Gyuri1999/smart-meter/smart_meter_ESP32-C3.pdf

Smart Meter — ESP32-C3 · ZMPT101B + SCT-013 | smart_meter.ino

# Smart Meter με ESP32-C3 Mini

Μέτρηση τάσης με ZMPT101B (GPIO2) και ρεύματος με SCT-013 (GPIO0). Υπολογίζει Vrms, Irms, πραγματική και φαινόμενη ισχύ, συντελεστή ισχύος και kWh, και τα δημοσιεύει σε MQTT με Home

## Assistant auto-discovery. Οι τιμές βαθμονόμησης σε αυτό το έγγραφο είναι μετρημένες πάνω

στην πραγματική διάταξη, όχι θεωρητικές.

# 1. Συνδεσμολογία

Εξάρτημα | Ακροδέκτης | ESP32-C3 | Σημείωση
ZMPT101B | VCC | 3V3 | Κρίσιμο. Με 5 V το σημείο ηρεμίας πάει στα 2.5 V, η κορυφή χτυπάει στο ταβάνι του ADC (2.85 V) και το ημίτονο κόβεται· επιπλέον καταπονείται το GPIO2.
ZMPT101B | OUT | GPIO2 (ADC1_CH2) | Το ποτενσιόμετρο ρυθμίζει το πλάτος — δες §3
ZMPT101B | GND | GND | Κοινή γείωση
SCT-013 | σήμα (tip) | GPIO0 (ADC1_CH0) | Μέσο διαιρέτη 10k/10k → bias 1.65 V
SCT-013 | sleeve | GND | Το βέλος του clamp προς το φορτίο
R1 / R2 | 10 kΩ | 3V3 → GPIO0 → GND | Διαιρέτης πόλωσης· το 3V3 το μοιράζεται με το ZMPT101B
C | 10 µF | GPIO0 → GND | Χαμηλή σύνθετη αντίσταση για το AC σήμα
230V AC | ESP32-C3 Mini
~~~~~~~ | ~~~~~~~~~~~~~
L o---+---[ ZMPT101B ]--- OUT -------------------> GPIO2 | (ADC1_CH2)
| | VCC <-- 3V3 | !!! ΟΧΙ 5V !!!
N o---+ | GND <-- GND
3V3
[ ] R1 10k
SCT-013 (clamp) | |
+---------+ | +-----+-------> GPIO0 | (ADC1_CH0)
| tip | |----------------------------+ | |
| sleeve |----------------------------+ | === | C 10uF
+---------+ | | | |
[ ] R2 10k
GND---GND

* Το SCT-013 με έξοδο τάσης έχει ΕΝΣΩΜΑΤΩΜΕΝΟ burden -> ΜΗΝ βάλεις αντίσταση. * Το βέλος του clamp δείχνει προς το φορτίο, αλλιώς η ισχύς βγαίνει αρνητική. * Κοινή GND παντού. Το 3V3 τροφοδοτεί ΚΑΙ το ZMPT101B ΚΑΙ τον διαιρέτη.

# 2. Ρυθμίσεις Arduino IDE

### - Board: ESP32C3 Dev Module (πακέτο esp32 by Espressif· δοκιμασμένο σε 3.3.10)

- USB CDC On Boot: Enabled — χωρίς αυτό ο Serial βγαίνει στα pins και ο monitor μένει κενός

### - Serial Monitor: 115200 baud

### - Η ίδια έξοδος βγαίνει και στο UART0 (GPIO21=TX, GPIO20=RX) για μετατροπέα USB-TTL

- Βιβλιοθήκη: μόνο PubSubClient (Nick O’Leary). Οι υπολογισμοί δεν χρησιμοποιούν EmonLib.

# 3. Βαθμονόμηση — μετρημένες τιμές

Οι τέσσερις σταθερές στην αρχή του αρχείου. Οι τιμές που ακολουθούν προέκυψαν από σύγκριση με πολύμετρο και αμπεροτσιμπίδα πάνω στην πραγματική διάταξη.

Σταθερά | Τιμή | Πώς βρέθηκε
VCAL | 341.0 | Volt δικτύου ανά 1 V στο pin. Σύγκριση με πολύμετρο: ένδειξη 231.7 V έναντι 233 V → απόκλιση 0.55%. Αναπροσαρμογή: VCAL_νέο = VCAL_παλιό × (πολύμετρο ÷ ένδειξη).
ICAL | 25.75 | Ampere ανά 1 V στο pin. Θεωρητικά ένα SCT-013-030 θα ήθελε 30.0· το συγκεκριμένο clamp βγήκε ~25.8. Τέσσερις συγκρίσεις σε 4.6 και 8.8 A έδωσαν 25.99 / 25.77 / 25.86 / 25.41 — μέση τιμή 25.76, διασπορά 1%.
PHASE_SHIFT | 12 | Διόρθωση φάσης σε ολόκληρα δείγματα. Ο μετασχηματιστής του ZMPT101B εισάγει 27.9° μετατόπιση: χωρίς διόρθωση το PF βγαίνει 0.88 σε καθαρά ωμικό φορτίο και η ισχύς είναι 12% λάθος. Βρίσκεται αυτόματα από τη σάρωση [sweep].
PHASECAL | 1.0 | Λεπτή ρύθμιση μέσα σε ένα δείγμα (±2.5°). Δεν χρειάστηκε.

### Σειρά εργασιών. Πρώτα το σχήμα, μετά η κλίμακα, τέλος η φάση:

- Ρύθμισε το ποτενσιόμετρο ώστε το CF να είναι 1.35–1.45 και το max να μένει κάτω από 2800 mV. Όσο το

max είναι καρφωμένο στα 2853 το ημίτονο κόβεται, όποιο κι αν είναι το CF.
- Σύγκρινε την τάση με πολύμετρο και διόρθωσε το VCAL.
- Σύγκρινε το ρεύμα με αμπεροτσιμπίδα σε δύο διαφορετικά φορτία και διόρθωσε το ICAL. Δύο σημεία

αποδεικνύουν γραμμικότητα, ένα όχι.
- Με ωμικό φορτίο άναψε τη σάρωση φάσης και πέρασε το προτεινόμενο PHASE_SHIFT.

Το ZMPT101B συνδέεται στα 230 V AC. Κάθε επέμβαση με το κύκλωμα αποσυνδεδεμένο· για τη ρύθμιση του trimmer υπό τάση, μονωμένο κατσαβίδι και κλειστό κουτί.

# 4. Διαγνωστικά στη σειριακή

Με PRINT_DEBUG 1 τυπώνονται τρία εργαλεία που φτιάχτηκαν ακριβώς για να στηθεί αυτή η διάταξη:

Γραμμή | Τι σου λέει
[dbg] | Τα δύο offsets (πρέπει και τα δύο ~1650 mV), ο αριθμός δειγμάτων (~2800 με σήμα, ~70 χωρίς), τα άκρα του καναλιού τάσης και το crest factor. Προειδοποιεί όταν η κορυφή ακουμπάει το ταβάνι του ADC.
[I-only] | Μέτρηση ρεύματος σε σταθερό παράθυρο 300 ms, ανεξάρτητη από την τάση. Τρέχει μόνη της όταν δεν υπάρχει σήμα τάσης, ώστε να ελέγχεις το clamp χωριστά. Δείχνει και το ptp: πραγματικό ημίτονο έχει ptp ≈ 2.83 × rms, ενώ ο θόρυβος 10–20 φορές το rms.
[sweep] | Καταγράφει 2048 δείγματα και δοκιμάζει 49 μετατοπίσεις φάσης. Με ωμικό φορτίο, η μετατόπιση με το μέγιστο PF είναι η σωστή. Τρέχει αυτόματα πάνω από 1 A.

# 5. MQTT

Συμπλήρωσε SSID, κωδικό και IP του broker στην αρχή του αρχείου. Με USE_MQTT 0 ο μετρητής δουλεύει αυτόνομος. Το <id> είναι τα τρία τελευταία byte της MAC και τυπώνεται στην εκκίνηση.

Topic | Περιεχόμενο
smartmeter/<id>/state | JSON με όλες τις μετρήσεις, κάθε 5 s
smartmeter/<id>/availability | online / offline (retained, με Last Will)
homeassistant/sensor/smartmeter_<i d>/…/config | Έξι μηνύματα auto-discovery, retained. Απενεργοποιούνται με HA_DISCOVERY 0
smartmeter/<id>/availability | online
smartmeter/<id>/state | {"v":232.61,"i":9.012,"p":2087.3,"s":2096.3,"pf":1.00,"e":0.1153,"rssi":-69}

Το Home Assistant φτιάχνει μόνο του μία συσκευή «Smart Meter» με έξι οντότητες. Η ενέργεια δηλώνεται total_increasing, οπότε μπαίνει στον Energy Dashboard.

# 6. Παράδειγμα εξόδου

==================================================
Smart Meter - ESP32-C3 | ZMPT101B(GPIO2) SCT-013(GPIO0)
==================================================
VCAL=341.00 | ICAL=25.75 | PHASECAL=1.00 | PHASE_SHIFT=12
Device ID : 8459a0
MQTT topic: smartmeter/8459a0/state
Εξοδος | : USB CDC + UART0 (GPIO21=TX, GPIO20=RX) @ 115200 baud
[wifi] συνδεθηκε: IP=192.168.1.43 | gateway=192.168.1.1 | RSSI=-69 dBm
[mqtt] συνδέθηκε στον 192.168.1.17
[mqtt] στάλθηκε το Home Assistant discovery
V= 232.61 V | I= 9.012 A | P= | 2087.3 W | S= | 2096.3 VA | PF= 1.00 | E= | 0.115 kWh

# 7. Κώδικας — smart_meter.ino

Τα στοιχεία WiFi και MQTT εμφανίζονται ως placeholder.

1 /* ============================================================================
2 | SMART METER | -- | ESP32-C3 Mini
3 | ----------------------------------------------------------------------------
4 | Αισθητήρας τάσης | : ZMPT101B (module με τελεστικό + ποτενσιόμετρο) -> GPIO2
5 | Αισθητήρας ρεύματος: SCT-013 30A/1V (έξοδος τάσης, ΜΕ εσωτερικό burden)
6 | -> GPIO0, με διαιρέτη τάσης 10k/10k (bias 1.65V)
7 | και πυκνωτή 10uF από το μέσο του διαιρέτη προς GND.
8
9 | Μετράει: Vrms, Irms, Πραγματική Ισχύ (W), Φαινόμενη (VA), cos(φ), kWh
10 | και τα δημοσιεύει σε MQTT (με προαιρετικό Home Assistant auto-discovery).
11
12 Απαιτεί τη βιβλιοθήκη: PubSubClient (Nick O'Leary) - Library Manager. 13
14 | !!! ΠΡΟΣΟΧΗ: το ZMPT101B συνδέεται στα 230V AC. Δούλεψε με το κύκλωμα
15 | ΑΠΟΣΥΝΔΕΔΕΜΕΝΟ από το δίκτυο. Μόνωση, κουτί, ασφάλεια.
16 | ============================================================================ */
17
18 // ------------------------------------------------------------ WiFi / MQTT
19 #define USE_MQTT | 1 | // 0 = μόνο σειριακή, χωρίς δίκτυο
20 #define HA_DISCOVERY | 1 | // 1 = αυτόματη αναγνώριση από Home Assistant
21
22 #if USE_MQTT
23 | #include <WiFi.h>
24 | #include <PubSubClient.h>
25
26 | static const char *WIFI_SSID = "TO_DIKTYO_MOU";
27 | static const char *WIFI_PASS = "TO_PASSWORD_MOU";
28
29 | static const char *MQTT_HOST = "192.168.1.17"; | // IP του broker
30 | static const uint16_t MQTT_PORT = 1883;
31 | static const char *MQTT_USER = "O_XRHSTHS_MOU"; | // "" αν δεν χρειάζεται
32 | static const char *MQTT_PASS = "TO_PASSWORD_TOU_BROKER";
33
34 | static const char *MQTT_BASE = "smartmeter"; | // ρίζα των topics
35 | static const uint32_t PUBLISH_EVERY_MS = 5000; | // κάθε πότε δημοσιεύουμε
36 #endif
37
38 // ---------------------------------------------------------------- ΑΚΡΟΔΕΚΤΕΣ
39 static const int PIN_VOLT = 2; | // ZMPT101B | OUT | (ADC1_CH2)
40 static const int PIN_CURR = 0; | // SCT-013 | sig | (ADC1_CH0)
41
42 // ------------------------------------------------------------- ΒΑΘΜΟΝΟΜΗΣΗ
43 // VCAL: πόσα Volt AC του δικτύου αντιστοιχούν σε 1 V στο pin.
44 // | Ξεκίνα με 260.0 και διόρθωσε: VCAL_new = VCAL_old * (Vπολύμετρου / Vσειριακής)
45 float VCAL = 341.0f;
46
47 // ICAL: πόσα Ampere αντιστοιχούν σε 1 V στο pin.
48 // | SCT-013-030 (30A/1V) απευθείας στο pin | -> 30.0
49 // | SCT-013-010 (10A/1V) | -> 10.0
50 // | Αν έβαλες επιπλέον διαιρέτη ΠΑΝΩ στο σήμα (π.χ. /2) -> διπλασίασε το.
51 float ICAL = 25.75f;
52
53 // PHASECAL: διόρθωση διαφοράς φάσης V/I (1.0 = καμία διόρθωση).
54 // | Ρύθμισέ το με καθαρά ωμικό φορτίο ώστε cos(φ) ~ 1.00 (τυπικά 0.8 - 2.2)
55 float PHASECAL = 1.0f;
56
57 // PHASE_SHIFT: χονδρική διόρθωση φάσης σε ΟΛΟΚΛΗΡΑ δείγματα (το PHASECAL
58 // καλύπτει μόνο ±1 δείγμα = ±2.5 μοίρες, πολύ λίγο για τη μετατόπιση που 59 // εισάγει ο μετασχηματιστής του ZMPT101B). Θετικό = καθυστερεί την τάση.

60 // Βρες την τιμή με τη σάρωση [sweep] που τρέχει αυτόματα υπό φορτίο.
61 int PHASE_SHIFT = 12;
62
63 // -------------------------------------------------------------- ΔΕΙΓΜΑΤΟΛΗΨΙΑ
64 static const int | HALF_CYCLES | = 40; | // 39 ημιπερίοδοι = 19.5 περίοδοι @50Hz (~390 ms)
65 static const uint32_t TIMEOUT_MS | = 1500; | // ασφάλεια αν δεν υπάρχει σήμα
66 static const double | FILT_TAU | = 1024.0; // σταθερά φίλτρου DC offset
67 static const float | NOISE_V | = 5.0f; | // κάτω από αυτό -> 0 (Volt)
68 static const float | NOISE_I | = 0.50f; | // κάτω από αυτό -> 0 (μετρημένος θόρυβος ~0.3 A)
69
70 // Αν το clamp είναι ανάποδα και δεν βολεύει να το γυρίσεις (π.χ. μόνιμη
71 // εγκατάσταση), βάλε 1 και αντιστρέφεται το πρόσημο της ισχύος από λογισμικό.
72 #define INVERT_CURRENT 0
73
74 #define PRINT_DEBUG 1 | // 1 = τύπωσε offsets/δείγματα
75
76 // --------------------------------------------------------------- ΜΕΤΑΒΛΗΤΕΣ 77 static double offsetV = 1650.0; // DC offset σε mV (ξεκινά στο μισό των 3.3V) 78 static double offsetI = 1650.0;
79
80 static double energy_Wh = 0.0; // συσσωρευμένη ενέργεια
81 static uint32_t lastEnergy_ms = 0;
82
83 struct Reading {
84 | float | vrms; | // V
85 | float | irms; | // A
86 | float | realPower; | // W
87 | float | apparentPower; // VA
88 | float | powerFactor; | // 0..1
89 | int | samples;
90 | int | vmin, vmax; | // ακραίες τιμές του καναλιού τάσης, σε mV (έλεγχος clipping)
91 | bool | ok;
92 };
93
94 // ------------------------------------------------------------------ ΕΞΟΔΟΣ 95 // Τα μηνύματα βγαίνουν ταυτόχρονα σε δύο σημεία:
96 // | * USB CDC | -> ο Serial Monitor μέσω του καλωδίου προγραμματισμού
97 // | * hardware UART0 -> GPIO21 = TX, GPIO20 = RX, για μετατροπέα USB-TTL
98 // Έτσι βλέπεις την έξοδο ακόμη κι αν το USB CDC δεν είναι διαθέσιμο (π.χ. 99 // λάθος ρύθμιση "USB CDC On Boot", ή όταν το ESP32 τροφοδοτείται χωριστά). 100 #define LOG_TO_UART 1
101 static const uint32_t LOG_BAUD = 115200;
102
103 // Αν το USB CDC είναι απενεργοποιημένο, ο Serial ΕΙΝΑΙ ήδη ο UART0 -> μη 104 // γράψεις δύο φορές στο ίδιο πράγμα.
105 #if LOG_TO_UART && ARDUINO_USB_CDC_ON_BOOT
106 #define LOG_DUAL 1
107 #else
108 #define LOG_DUAL 0
109 #endif
110
111 static void logBegin() {
112 Serial.begin(LOG_BAUD);
113 #if LOG_DUAL
114 | Serial0.begin(LOG_BAUD); | // GPIO21 TX / GPIO20 RX
115 #endif
116 | // Με USB CDC η θύρα ξαναδηλώνεται στο USB μετά το reset. Χωρίς αυτή την
117 | // αναμονή, τα πρώτα μηνύματα χάνονται πριν προλάβει να συνδεθεί ο monitor.
118 | while (!Serial && millis() < 3000) delay(10);
119 | delay(500);
120 }
121
122 static void logf(const char *fmt, ...) {
123 | char buf[224];
124 | va_list ap;
125 | va_start(ap, fmt);
126 | vsnprintf(buf, sizeof(buf), fmt, ap);
127 | va_end(ap);
128
129 Serial.print(buf);
130 #if LOG_DUAL
131 Serial0.print(buf);
132 #endif
133 }
134
135 // ------------------------------------------------------------------ ΜΕΤΡΗΣΗ 136 static Reading measure() {
137 Reading r = {0, 0, 0, 0, 0, 0, 5000, 0, false};

139 const uint32_t tStart = millis();
140
141 | // 1) Warm-up: αφήνουμε το φίλτρο DC offset να "κλειδώσει"
142 | while (millis() - tStart < 60) {
143 | offsetV += (analogReadMilliVolts(PIN_VOLT) - offsetV) / FILT_TAU;
144 | offsetI += (analogReadMilliVolts(PIN_CURR) - offsetI) / FILT_TAU;
145 | }
146
147 | // 2) Κύρια δειγματοληψία, συγχρονισμένη σε μηδενισμούς της τάσης
148 | const int PBUF = 32; | // > |PHASE_SHIFT| + 1
149 | static double pbufV[32], pbufI[32];
150 | int tick = 0;
151
152 | double sumV = 0, sumI = 0, sumP = 0;
153 | double lastFilteredV = 0;
154 | int | crossCount = 0;
155 | int | n = 0;
156 | bool | started = false;
157
158 | // Αρχικοποίηση προσήμου από το τρέχον δείγμα, ώστε ο πρώτος μηδενισμός
159 | // που θα ανιχνευτεί να είναι πραγματικός -> αθροίζουμε ακέραιο αριθμό
160 | // ημιπεριόδων και το RMS βγαίνει ακριβές.
161 | bool | lastSign = (analogReadMilliVolts(PIN_VOLT) - offsetV) > 0;
162
163 | while (crossCount < HALF_CYCLES) {
164 | if (millis() - tStart > TIMEOUT_MS) return r; | // ok = false
165
166 | int | rawV = analogReadMilliVolts(PIN_VOLT);
167 | double sV = rawV;
168 | double sI = analogReadMilliVolts(PIN_CURR);
169
170 | if (rawV < r.vmin) r.vmin = rawV;
171 | if (rawV > r.vmax) r.vmax = rawV;
172
173 | offsetV += (sV - offsetV) / FILT_TAU;
174 | offsetI += (sI - offsetI) / FILT_TAU;
175
176 | double fV = sV - offsetV; | // AC συνιστώσα τάσης | (mV στο pin)
177 | double fI = sI - offsetI; | // AC συνιστώσα ρεύματος (mV στο pin)
178
179 | bool sign = (fV > 0);
180 | if (sign != lastSign) {
181 | crossCount++;
182 | if (!started) { | // ξεκίνα να αθροίζεις από τον 1ο μηδενισμό
183 | started = true;
184 | sumV = sumI = sumP = 0;
185 | n = 0;
186 | }
187 | }
188 | lastSign = sign;
189
190 | // Γράψε τα δείγματα στον κυκλικό buffer και διάβασε τα μετατοπισμένα.
191 | int pi = tick % PBUF;
192 | pbufV[pi] = fV;
193 | pbufI[pi] = fI;
194 | int kv = (PHASE_SHIFT > 0) ? | PHASE_SHIFT : 0; | // καθυστέρηση τάσης
195 | int ki = (PHASE_SHIFT < 0) ? -PHASE_SHIFT : 0; | // καθυστέρηση ρεύματος
196 | double v0 = pbufV[(pi - kv | + PBUF) % PBUF];
197 | double v1 = pbufV[(pi - kv - 1 + PBUF) % PBUF];
198 | double phaseShiftedV = v1 + PHASECAL * (v0 - v1); | // λεπτή ρύθμιση
199 | double iShifted | = pbufI[(pi - ki + PBUF) % PBUF];
200
201 | if (started && tick >= PBUF) {
202 | sumV += fV * fV;
203 | sumI += fI * fI;
204 | sumP += phaseShiftedV * iShifted;
205 | n++;
206 | }
207 | tick++;
208 | lastFilteredV = fV;
209 | }
210
211 if (n < 10) return r;
212
213 | // 3) Υπολογισμοί (mV -> V, μετά επί τους συντελεστές βαθμονόμησης)
214 | double vrms_pin = sqrt(sumV / n) / 1000.0; | // V στο pin
215 | double irms_pin = sqrt(sumI / n) / 1000.0; | // V στο pin
216
217 | r.vrms | = VCAL * vrms_pin;

218 | r.irms | = ICAL * irms_pin;
219 | r.realPower = VCAL * ICAL * (sumP / n) / 1.0e6;
220
221 | if (r.vrms < NOISE_V) { r.vrms = 0; r.realPower = 0; }
222 | if (r.irms < NOISE_I) { r.irms = 0; r.realPower = 0; }
223
224 #if INVERT_CURRENT
225 r.realPower = -r.realPower;
226 #endif
227
228 | r.apparentPower = r.vrms * r.irms;
229 | r.powerFactor | = (r.apparentPower > 0.5f) ? (r.realPower / r.apparentPower) : 0.0f;
230 | if (r.powerFactor > | 1.0f) r.powerFactor = | 1.0f;
231 | if (r.powerFactor < -1.0f) r.powerFactor = -1.0f;
232
233 | r.samples = n;
234 | r.ok = true;
235 | return r;
236 }
237
238 // ------------------------------------------------------------- ΔΙΚΤΥΟ MQTT 239 #if USE_MQTT
240
241 static WiFiClient wifiClient;
242 static PubSubClient mqtt(wifiClient);
243
244 static char devId[8] | = ""; | // τα 3 τελευταία byte της MAC, π.χ. "a1b2c3"
245 static char t_state[64] = ""; | // smartmeter/a1b2c3/state
246 static char t_avail[64] = ""; | // smartmeter/a1b2c3/availability
247 static uint32_t lastNetTry | = 0;
248 static uint32_t lastPublish = 0;
249
250 // Στοιχεία που δημοσιεύονται. Το "key" είναι και το πεδίο του JSON. 251 struct SensorDef {
252 const char *key, *name, *unit, *devClass, *stateClass;
253 };
254 static const SensorDef SENSORS[] = {
255 | {"v", | "Τάση", | "V", | "voltage", | "measurement"},
256 | {"i", | "Ρεύμα", | "A", | "current", | "measurement"},
257 | {"p", | "Ισχύς", | "W", | "power", | "measurement"},
258 | {"s", | "Φαινόμενη ισχύς", | "VA", | "apparent_power", "measurement"},
259 | {"pf", "Συντελεστής ισχύος", "", | "power_factor", | "measurement"},
260 | {"e", | "Ενέργεια", | "kWh", "energy", | "total_increasing"},
261 };
262
263 static void netSetup() {
264 | WiFi.mode(WIFI_STA);
265 | WiFi.setSleep(false); | // σταθερότερη σύνδεση, λιγότερα stalls
266 | WiFi.begin(WIFI_SSID, WIFI_PASS);
267
268 | uint8_t mac[6];
269 | WiFi.macAddress(mac);
270 | snprintf(devId, | sizeof(devId), | "%02x%02x%02x", mac[3], mac[4], mac[5]);
271 | snprintf(t_state, sizeof(t_state), "%s/%s/state", | MQTT_BASE, devId);
272 | snprintf(t_avail, sizeof(t_avail), "%s/%s/availability", MQTT_BASE, devId);
273
274 | mqtt.setServer(MQTT_HOST, MQTT_PORT);
275 | mqtt.setBufferSize(1024); | // τα payloads του discovery δεν χωράνε στα 256
276
277 | logf(" Device ID : %s\n", devId);
278 | logf(" MQTT topic: %s\n", t_state);
279 }
280
281 #if HA_DISCOVERY
282 // Στέλνει ένα retained "config" topic ανά μέγεθος, ώστε το Home Assistant να 283 // φτιάξει μόνο του τις οντότητες κάτω από μία συσκευή.
284 static void publishDiscovery() {
285 char topic[96], payload[640], unitField[48];
286
287 | for (const SensorDef &s : SENSORS) {
288 | snprintf(topic, sizeof(topic),
289 | "homeassistant/sensor/%s_%s/%s/config", MQTT_BASE, devId, s.key);
290
291 | unitField[0] = '\0';
292 | if (s.unit[0]) snprintf(unitField, sizeof(unitField), "\"unit_of_meas\":\"%s\",", s.unit);
293
294 | snprintf(payload, sizeof(payload),
295 | "{\"name\":\"%s\",\"uniq_id\":\"%s_%s_%s\",\"stat_t\":\"%s\",\"avty_t\":\"%s\","
296 | "%s\"dev_cla\":\"%s\",\"stat_cla\":\"%s\",\"val_tpl\":\"{{ value_json.%s }}\","

"\"dev\":{\"ids\":[\"%s_%s\"],\"name\":\"Smart Meter\",\"mf\":\"DIY\"," "\"mdl\":\"ESP32-C3 + ZMPT101B + SCT-013\"}}",
s.name, MQTT_BASE, devId, s.key, t_state, t_avail,
unitField, s.devClass, s.stateClass, s.key,
MQTT_BASE, devId);
303 | mqtt.publish(topic, payload, true); | // retained
}
logf(" [mqtt] στάλθηκε το Home Assistant discovery\n"); 306 }
307 #endif

309 // Μη μπλοκάρουσα διαχείριση σύνδεσης: καλείται συνέχεια από τη loop(). 310 static void netLoop() {
if (WiFi.status() != WL_CONNECTED) {
if (millis() - lastNetTry > 10000) {
lastNetTry = millis();
logf(" [wifi] επανασύνδεση...\n"); WiFi.disconnect();
WiFi.begin(WIFI_SSID, WIFI_PASS); }
return;
}

// Μόλις συνδεθεί το WiFi, τύπωσε μία φορά τη διεύθυνση που πήρε. static bool ipShown = false;
if (!ipShown) {
ipShown = true;
325 | logf(" [wifi] συνδεθηκε: IP=%s | gateway=%s | RSSI=%d dBm\n",
WiFi.localIP().toString().c_str(), WiFi.gatewayIP().toString().c_str(),
| WiFi.RSSI());
}
| if (!mqtt.connected()) {
if (millis() - lastNetTry > 5000) {
| lastNetTry = millis();
| char clientId[32];
snprintf(clientId, sizeof(clientId), "%s_%s", MQTT_BASE, devId);

// Last Will: αν χαθεί η συσκευή, ο broker στέλνει μόνος του "offline". bool ok = mqtt.connect(clientId,
MQTT_USER[0] ? MQTT_USER : nullptr, MQTT_PASS[0] ? MQTT_PASS : nullptr, t_avail, 0, true, "offline");
| if (ok) {
logf(" [mqtt] συνδέθηκε στον %s\n", MQTT_HOST); mqtt.publish(t_avail, "online", true);
345 #if HA_DISCOVERY
| publishDiscovery();
347 #endif
| } else {
logf(" [mqtt] αποτυχία (rc=%d)\n", mqtt.state());
| }
| }
| return;
}
| mqtt.loop();
356 }

358 static void publishState(const Reading &r) {
| if (!mqtt.connected()) return;
| char payload[192];
| snprintf(payload, sizeof(payload),
"{\"v\":%.2f,\"i\":%.3f,\"p\":%.1f,\"s\":%.1f,\"pf\":%.2f,\"e\":%.4f,\"rssi\":%d}", r.vrms, r.irms, r.realPower, r.apparentPower, r.powerFactor,
energy_Wh / 1000.0, WiFi.RSSI());
| mqtt.publish(t_state, payload);
368 }

370 #endif // USE_MQTT

372 // Μετράει ΜΟΝΟ ρεύμα, σε σταθερό παράθυρο χρόνου - δεν εξαρτάται από τους 373 // μηδενισμούς της τάσης. Χρήσιμο για να ελέγξεις το clamp μόνο του, πριν 374 // συνδέσεις το ZMPT101B στο δίκτυο. Τυπώνει και το πλάτος σε mV, ώστε να 375 // ξεχωρίζεις πραγματικό σήμα από θόρυβο.

376 static void currentOnlyReport(uint32_t windowMs) {
377 | const uint32_t t0 = millis();
378 | double sumI = 0;
379 | int n = 0, mn = 5000, mx = 0;
380
381 | while (millis() - t0 < windowMs) {
382 | int raw = analogReadMilliVolts(PIN_CURR);
383 | if (raw < mn) mn = raw;
384 | if (raw > mx) mx = raw;
385 | offsetI += (raw - offsetI) / FILT_TAU;
386 | double fI = raw - offsetI;
387 | sumI += fI * fI;
388 | n++;
389 | }
390
391 | float irms = (n > 9) ? (float)(ICAL * sqrt(sumI / n) / 1000.0) : 0.0f;
392 | logf("[I-only] Irms=%.3f A | ptp=%dmV (%d..%d) | %d δείγματα σε %ums -> %.1f kSPS\n",
393 | irms, mx - mn, mn, mx, n, windowMs, n / (float)windowMs);
394 }
395
396 // ------------------------------------------------------------- ΣΑΡΩΣΗ ΦΑΣΗΣ 397 // Καταγράφει ~290 ms ωμής κυματομορφής και υπολογίζει το PF για κάθε πιθανή 398 // μετατόπιση. Με ΩΜΙΚΟ φορτίο, η μετατόπιση που δίνει το μέγιστο PF είναι η 399 // σωστή τιμή για το PHASE_SHIFT.
400 #define SWEEP_N | 2048
401 #define SWEEP_MAX_K | 24
402
403 static void phaseSweep() {
404 static float bufV[SWEEP_N], bufI[SWEEP_N]; 405
406 | uint32_t t0 = micros();
407 | for (int n = 0; n < SWEEP_N; n++) {
408 | double sV = analogReadMilliVolts(PIN_VOLT);
409 | double sI = analogReadMilliVolts(PIN_CURR);
410 | offsetV += (sV - offsetV) / FILT_TAU;
411 | offsetI += (sI - offsetI) / FILT_TAU;
412 | bufV[n] = sV - offsetV;
413 | bufI[n] = sI - offsetI;
414 | }
415 | float fs = SWEEP_N / ((micros() - t0) / 1.0e6f); | // πραγματικός ρυθμός
416
417 | const int a = SWEEP_MAX_K, b = SWEEP_N - SWEEP_MAX_K;
418 | double sv = 0, si = 0;
419 | for (int n = a; n < b; n++) { sv += (double)bufV[n]*bufV[n]; si += (double)bufI[n]*bufI[n]; }
420 | double vr = sqrt(sv / (b - a)), ir = sqrt(si / (b - a));
421
422 if (vr < 50.0 || ir < 20.0) { logf("[sweep] πολύ μικρό σήμα - βάλε φορτίο\n"); return; } 423
424 | // ΠΡΟΣΟΧΗ: η σάρωση δουλεύει πάνω σε ωμά δείγματα, ΧΩΡΙΣ να εφαρμόζει το
425 | // PHASE_SHIFT. Άρα το bestK είναι η απόλυτη τιμή που πρέπει να μπει εκεί,
426 | // όχι κάτι που προστίθεται στην τρέχουσα.
427 | int bestK = 0; double bestPF = 0, pf0 = 0, pfCur = 0;
428 | for (int k = -SWEEP_MAX_K; k <= SWEEP_MAX_K; k++) {
429 | double sp = 0;
430 | for (int n = a; n < b; n++) sp += (double)bufV[n - k] * bufI[n];
431 | double pf = sp / ((b - a) * vr * ir);
432 | if (k == 0) | pf0 | = pf;
433 | if (k == PHASE_SHIFT) pfCur = pf;
434 | if (fabs(pf) > fabs(bestPF)) { bestPF = pf; bestK = k; }
435 | }
436
437 | logf("[sweep] fs=%.0fHz | αδιορθωτο(0)=%.3f | τρεχον(%d)=%.3f | ΒΕΛΤΙΣΤΟ PHASE_SHIFT=%d -> PF=%.3f (%.1f μοιρες)\n",
438 | fs, pf0, PHASE_SHIFT, pfCur, bestK, bestPF,
439 | bestK * 360.0f * 50.0f / fs);
440 | if (bestPF < 0) logf("[sweep] ΠΡΟΣΟΧΗ: αρνητικο PF -> το clamp ειναι αναποδα\n");
441 }
442
443 // -------------------------------------------------------------------- SETUP
444 void setup() {
445 logBegin();
446
447 | analogReadResolution(12); | // 0..4095
448 | analogSetPinAttenuation(PIN_VOLT, ADC_11db); | // πλήρες εύρος ~0..3.1V
449 | analogSetPinAttenuation(PIN_CURR, ADC_11db);
450
451 | logf("\n");
452 | logf("==================================================\n");
453 | logf(" Smart Meter - ESP32-C3 | ZMPT101B(GPIO2) SCT-013(GPIO0)\n");
454 | logf("==================================================\n");

455 | logf(" VCAL=%.2f | ICAL=%.2f | PHASECAL=%.2f\n", VCAL, ICAL, PHASECAL);
456 #if LOG_DUAL
457 | logf(" Εξοδος | : USB CDC + UART0 (GPIO21=TX, GPIO20=RX) @ %u baud\n", LOG_BAUD);
458 #else
459 | logf(" Εξοδος | : UART0 (GPIO21=TX, GPIO20=RX) @ %u baud\n", LOG_BAUD);
460 #endif
461 logf("\n");
462
463 #if USE_MQTT
464 netSetup();
465 #endif
466
467 | // Μια "τυφλή" μέτρηση για να σταθεροποιηθούν τα φίλτρα
468 | measure();
469 | lastEnergy_ms = millis();
470 }
471
472 // --------------------------------------------------------------------- LOOP 473 void loop() {
474 #if USE_MQTT
475 netLoop();
476 #endif
477
478 Reading r = measure();
479
480 | uint32_t now = millis();
481 | float dt_h = (now - lastEnergy_ms) / 3600000.0f; | // ms -> ώρες
482 | lastEnergy_ms = now;
483
484 | if (!r.ok) {
485 | logf("[!] Δεν ανιχνεύτηκε σήμα τάσης (timeout). Ελέγξτε ZMPT101B / GPIO2.\n");
486 | delay(1000);
487 | return;
488 | }
489
490 energy_Wh += r.realPower * dt_h;
491
492 | // Χωρίς σήμα τάσης η μέτρηση ρεύματος δεν είναι αξιόπιστη (το παράθυρο
493 | // ορίζεται από τους μηδενισμούς της τάσης) -> κάνε ξεχωριστή μέτρηση.
494 | if (r.vrms <= 0.0f) currentOnlyReport(300);
495
496 #if PRINT_DEBUG
497 | // Με φορτίο πάνω από 1 A, τρέξε σάρωση φάσης κάθε 10 δευτερόλεπτα.
498 | static uint32_t lastSweep = 0;
499 | if (r.irms > 1.0f && millis() - lastSweep > 10000) {
500 | lastSweep = millis();
501 | phaseSweep();
502 | }
503 #endif
504
505 #if PRINT_DEBUG
506 | // Crest factor = κορυφή / ενεργός τιμή. Καθαρό ημίτονο -> 1.41.
507 | // Πολύ μικρότερο σημαίνει ότι το σήμα "πλακώνει" (saturation του τελεστικού).
508 | float vrmsPin_mV = (VCAL > 0) ? (r.vrms / VCAL * 1000.0f) : 0.0f;
509 | float crest = (vrmsPin_mV > 1.0f) ? ((r.vmax - r.vmin) / 2.0f) / vrmsPin_mV : 0.0f;
510
511 | logf("[dbg] offsetV=%.0fmV offsetI=%.0fmV samples=%d | V: %d..%d mV ptp=%d CF=%.2f %s\n",
512 | offsetV, offsetI, r.samples, r.vmin, r.vmax, r.vmax - r.vmin, crest,
513 | // Το ταβάνι του ADC είναι ~2850 mV: αν το ακουμπάμε, κόβεται η κορυφή
514 | // ΑΝΕΞΑΡΤΗΤΑ από το τι δείχνει το crest factor.
515 | (r.vmax > 2800 || r.vmin < 150) ? "<<< ΚΟΡΥΦΗ ΣΤΟ ΤΑΒΑΝΙ - χαμηλωσε κι αλλο"
516 | : (crest > 1.33f && crest < 1.50f) ? "OK"
517 | : (crest > 0.0f ? "<<< σχημα ακομα στραβο" : ""));
518 #endif
519
520 | logf("V=%7.2f V | I=%6.3f A | P=%8.1f W | S=%8.1f VA | PF=%5.2f | E=%9.3f kWh\n",
521 | r.vrms, r.irms, r.realPower, r.apparentPower,
522 | r.powerFactor, energy_Wh / 1000.0);
523
524 #if USE_MQTT
525 | if (millis() - lastPublish >= PUBLISH_EVERY_MS) {
526 | lastPublish = millis();
527 | publishState(r);
528 | }
529 #endif
530
531 delay(200);
532 }
