Gyuri1999/smart-meter/hardware/enclosure/preview_back.png

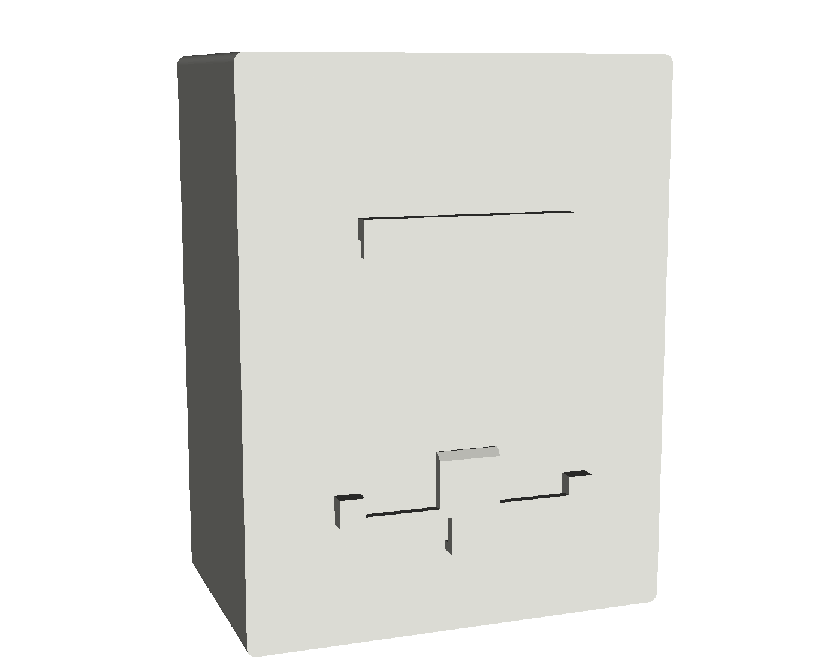
hardware/enclosure/preview_back.png
