Gyuri1999/smart-meter/hardware/enclosure/preview_open.png

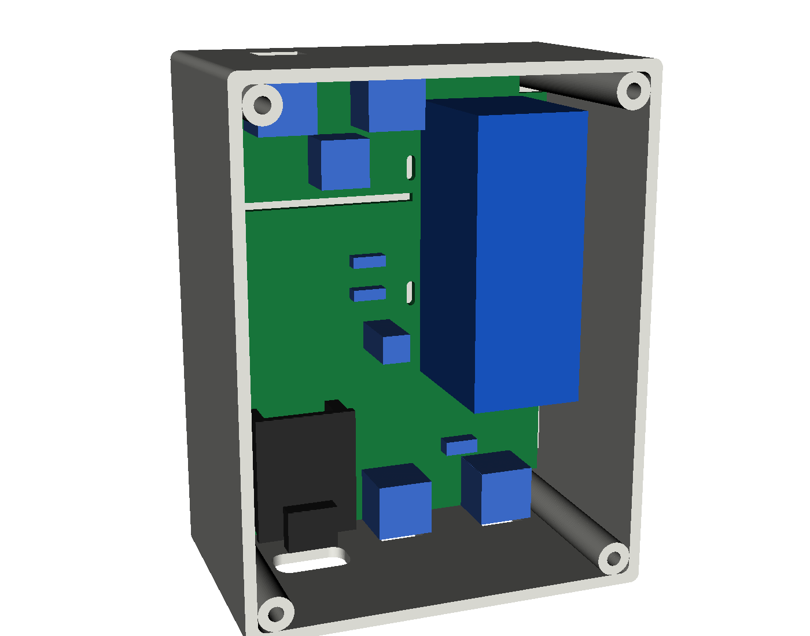
hardware/enclosure/preview_open.png
