Gyuri1999/smart-meter/hardware/pcb/placement.png

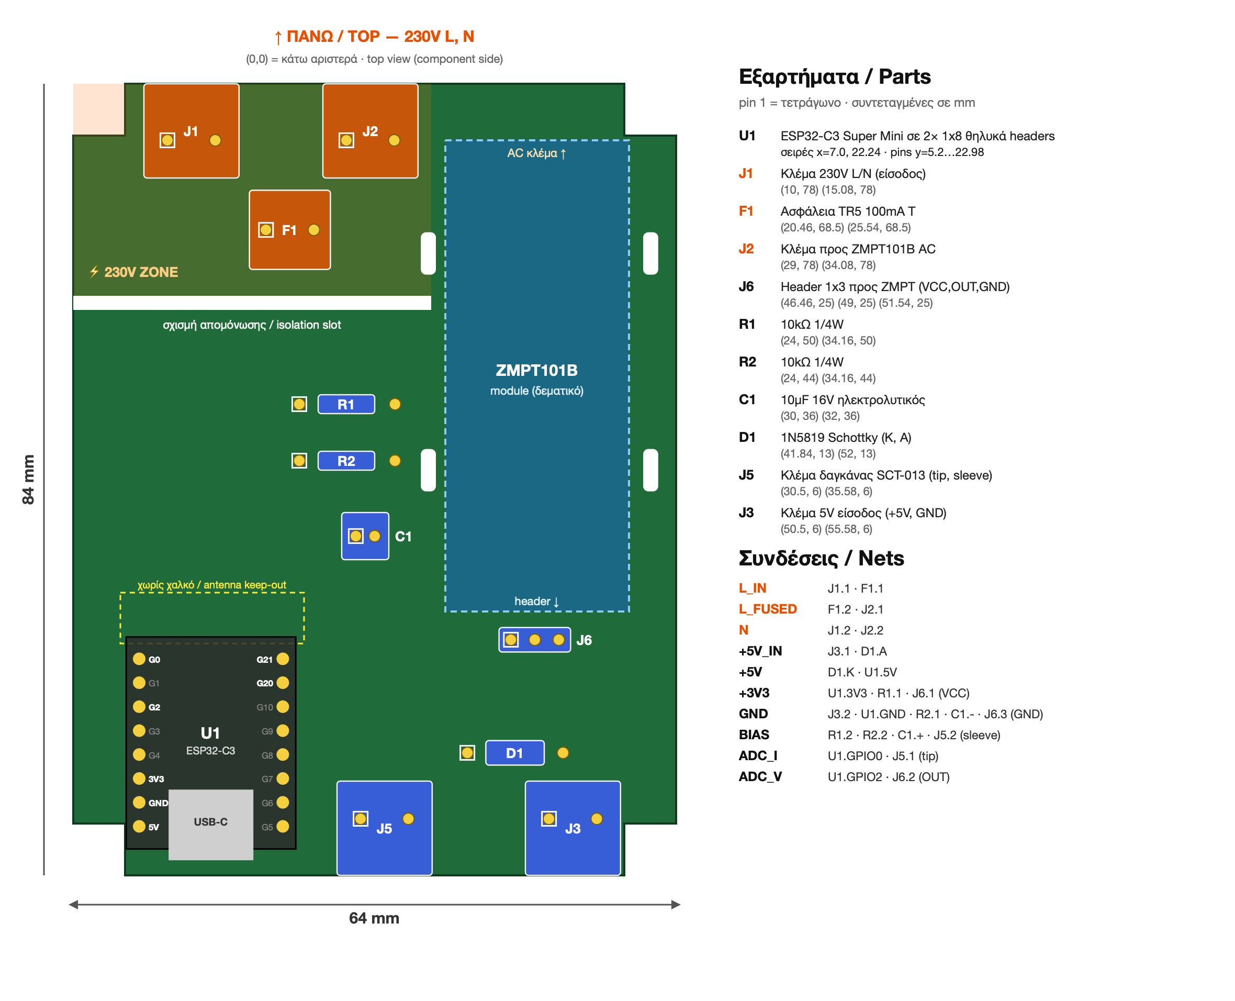
hardware/pcb/placement.png
