Gyuri1999/smart-meter/hardware/enclosure/smart_meter_assembly.step

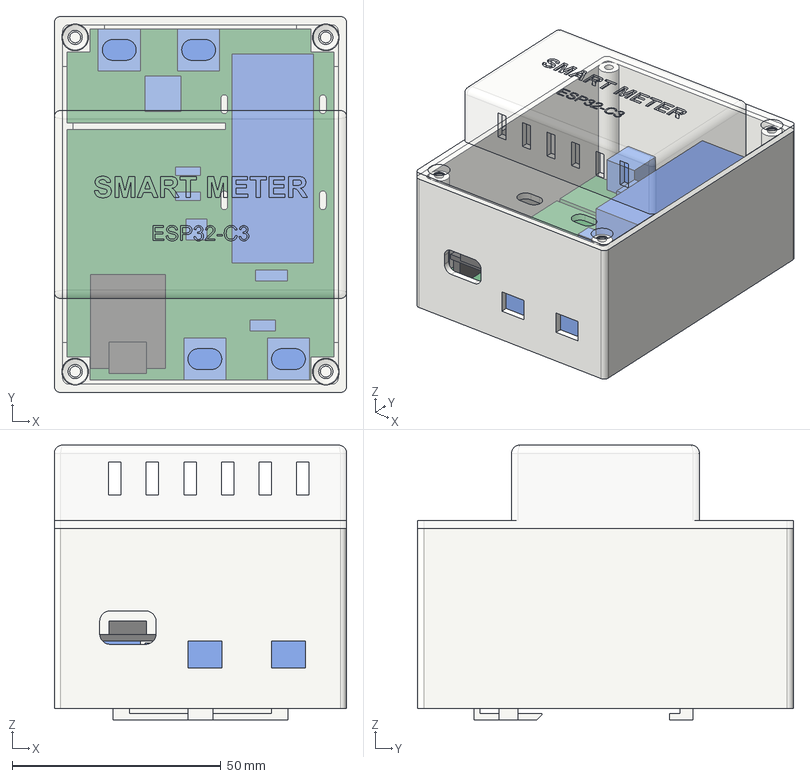
[picture p8: CAD file, 2026-10-21]
hardware/enclosure/smart_meter_assembly.step
70.0 x 90.0 x 65.8 mm
base
cover
pcb
parts
zmpt101b
esp32c3
