Gyuri1999/smart-meter/hardware/pcb/pcb_outline.dxf

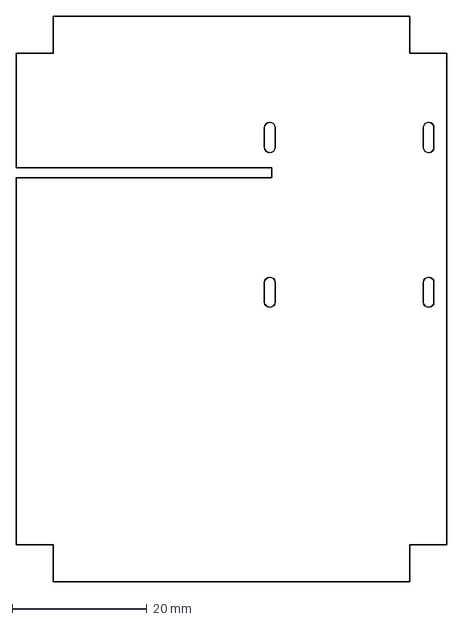
[picture p9: CAD file, 2026-10-21]
hardware/pcb/pcb_outline.dxf
64.0 x 84.0 mm
