Gyuri1999/smart-meter/hardware/enclosure/smart_meter_cover.step

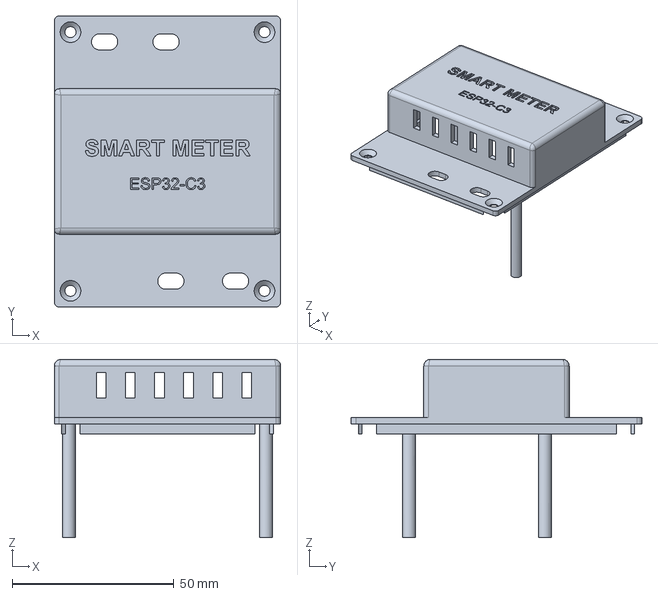
[picture p10: CAD file, 2026-10-21]
hardware/enclosure/smart_meter_cover.step
70.0 x 90.0 x 55.1 mm
