Gyuri1999/smart-meter/hardware/enclosure/smart_meter_base.step

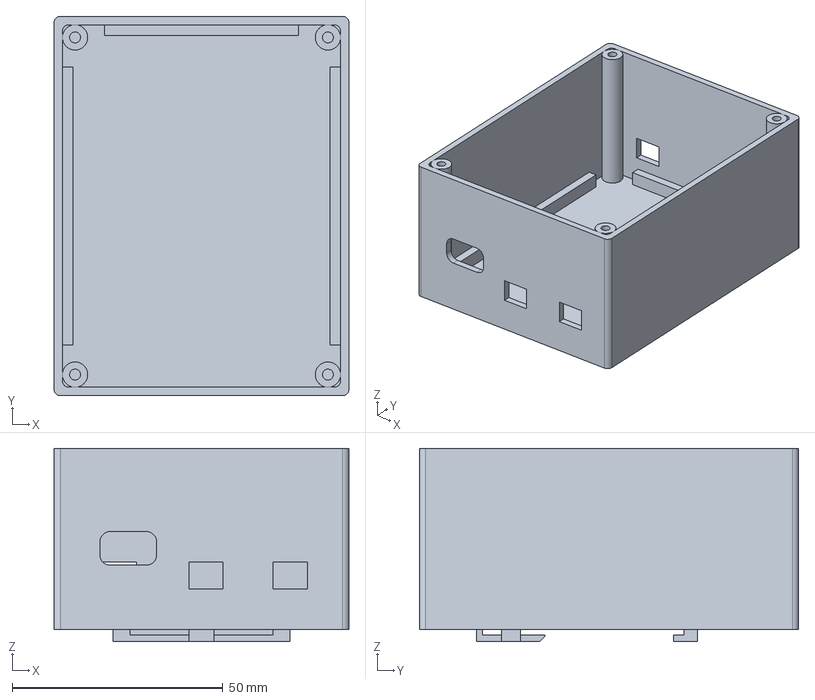
[picture p11: CAD file, 2026-10-21]
hardware/enclosure/smart_meter_base.step
70.0 x 90.0 x 45.8 mm
