Gyuri1999/smart-meter/(list of files, cad)

Other CAD files:
hardware/enclosure/smart_meter_base.stl
hardware/enclosure/smart_meter_cover.stl
