Gyuri1999/smart-meter/hardware/layout.py

"""
Κοινές διαστάσεις PCB και κουτιού / shared PCB + enclosure dimensions.

Όλα σε mm. Συντεταγμένες PCB: αρχή κάτω-αριστερά, x δεξιά, y πάνω
(όπως στο Fusion Electronics), κοιτώντας την πλευρά των εξαρτημάτων.
Πάνω άκρη (y = 84) = πλευρά 230V, κάτω άκρη (y = 0) = 5V / SCT / USB.
"""

# ------------------------------------------------------------------ PCB
PCB_W, PCB_H, PCB_T = 64.0, 84.0, 1.6
CORNER_NOTCH = 5.5           # εγκοπές στις γωνίες για τις κολόνες του κουτιού

# Σχισμή απομόνωσης 230V / isolation slot (x0, y0, x1, y1)
ISO_SLOT = (0.0, 60.0, 38.0, 61.5)

# Περιοχή όπου κάθεται το ZMPT101B module (x0, y0, x1, y1)
ZMPT_ZONE = (39.5, 28.0, 59.0, 78.0)
ZMPT_HEIGHT = 26.0           # ύψος module πάνω από την PCB (μετασχηματιστής)
# Σχισμές για δεματικό (zip tie): (cx, cy, w, h)
ZIP_SLOTS = [(37.7, 43.0, 1.6, 4.5), (61.3, 43.0, 1.6, 4.5),
             (37.7, 66.0, 1.6, 4.5), (61.3, 66.0, 1.6, 4.5)]

# ESP32-C3 Super Mini σε 2 x 1x8 θηλυκά pin headers, USB-C προς τα κάτω
ESP_COL_X = (7.0, 22.24)     # ΕΛΕΓΞΕ με παχύμετρο: απόσταση σειρών 15.24
ESP_PIN_Y0 = 5.2             # πιο κοντινό pin στο USB
ESP_PITCH = 2.54
ESP_BOARD = (5.62, 2.8, 23.62, 25.3)   # περίγραμμα πλακέτας ESP (x0,y0,x1,y1)
ESP_HEADER_H = 8.5           # ύψος θηλυκού header
ESP_LEFT_PINS = ["5V", "GND", "3V3", "GPIO4", "GPIO3", "GPIO2", "GPIO1", "GPIO0"]
ESP_RIGHT_PINS = ["GPIO5", "GPIO6", "GPIO7", "GPIO8", "GPIO9", "GPIO10", "GPIO20", "GPIO21"]
ANTENNA_KEEPOUT = (5.0, 24.6, 24.5, 30.0)

# Εξαρτήματα: ref -> (x, y) κέντρου ή pins, και ύψος για το 3D μοντέλο
# Κλέμες 5.08mm (π.χ. Phoenix MKDS 1,5/2-5,08): pins (x1,y), (x1+5.08,y)
PARTS = {
    #  ref   description                       pins [(x,y),...]                   body (x0,y0,x1,y1), height
    "J1": ("Κλέμα 230V L/N (είσοδος)",        [(10.0, 78.0), (15.08, 78.0)],     (7.5, 74.0, 17.6, 84.0), 10.0),
    "F1": ("Ασφάλεια TR5 100mA T",            [(20.46, 68.5), (25.54, 68.5)],    (18.7, 64.3, 27.3, 72.7), 8.0),
    "J2": ("Κλέμα προς ZMPT101B AC",          [(29.0, 78.0), (34.08, 78.0)],     (26.5, 74.0, 36.6, 84.0), 10.0),
    "J6": ("Header 1x3 προς ZMPT (VCC,OUT,GND)", [(46.46, 25.0), (49.0, 25.0), (51.54, 25.0)], (45.2, 23.7, 52.8, 26.3), 8.5),
    "R1": ("10kΩ 1/4W",                       [(24.0, 50.0), (34.16, 50.0)],     (26.0, 49.0, 32.0, 51.0), 2.5),
    "R2": ("10kΩ 1/4W",                       [(24.0, 44.0), (34.16, 44.0)],     (26.0, 43.0, 32.0, 45.0), 2.5),
    "C1": ("10µF 16V ηλεκτρολυτικός",         [(30.0, 36.0), (32.0, 36.0)],      (28.5, 33.5, 33.5, 38.5), 11.0),
    "D1": ("1N5819 Schottky (K, A)",          [(41.84, 13.0), (52.0, 13.0)],     (43.8, 11.7, 50.0, 14.3), 3.0),
    "J5": ("Κλέμα δαγκάνας SCT-013 (tip, sleeve)", [(30.5, 6.0), (35.58, 6.0)],  (28.0, 0.0, 38.1, 10.0), 10.0),
    "J3": ("Κλέμα 5V είσοδος (+5V, GND)",     [(50.5, 6.0), (55.58, 6.0)],       (48.0, 0.0, 58.1, 10.0), 10.0),
}

# Συνδέσεις / netlist
NETS = {
    "L_IN":   ["J1.1", "F1.1"],
    "L_FUSED": ["F1.2", "J2.1"],
    "N":      ["J1.2", "J2.2"],
    "+5V_IN": ["J3.1", "D1.A"],
    "+5V":    ["D1.K", "U1.5V"],
    "+3V3":   ["U1.3V3", "R1.1", "J6.1 (VCC)"],
    "GND":    ["J3.2", "U1.GND", "R2.1", "C1.-", "J6.3 (GND)"],
    "BIAS":   ["R1.2", "R2.2", "C1.+", "J5.2 (sleeve)"],
    "ADC_I":  ["U1.GPIO0", "J5.1 (tip)"],
    "ADC_V":  ["U1.GPIO2", "J6.2 (OUT)"],
}

# ---------------------------------------------------------------- ΚΟΥΤΙ
# DIN 4 θέσεων: 70 x 90, βάθος βάσης 45, μύτη 45 ύψος x 18 βάθος
BOX_W, BOX_H = 70.0, 90.0
WALL = 2.0
BASE_D = 43.0                # βάθος βάσης (πλάτη + τοιχώματα)
COVER_T = 2.0                # πάχος καπακιού -> σύνολο 45
NOSE_H, NOSE_D = 45.0, 18.0
PCB_OFFSET = (3.0, 3.0)      # θέση PCB (0,0) μέσα στο κουτί (X, Y)
PCB_Z = WALL + 4.0           # κάτω πλευρά PCB πάνω από την πίσω πλευρά
SCREW_POS = [(5.0, 5.0), (65.0, 5.0), (5.0, 85.0), (65.0, 85.0)]
RAIL_CENTER_Y = 45.0


def pcb_to_box(x, y):
    return x + PCB_OFFSET[0], y + PCB_OFFSET[1]
