Gyuri1999/smart-meter/(commit log)

2026-10-21 Smart meter ESP32-C3
2026-10-21 Σχηματικό σύνδεσης
2026-10-21 PCB για Fusion, κουτί με κλέμες
    [pcb_outline.dxf, smart_meter.brd, smart_meter_assembly.step, smart_meter_base.step, smart_meter_base.stl, smart_meter_cover.step, smart_meter_cover.stl]
2026-11-06 Βαθμονόμηση ρεύματος: ICAL 25.75 -> 24.9
    Με αμπεροτσιμπίδα και αερόθερμο: τσιμπίδα 4.50 A, smart meter 4.50 A
    μετά τη διόρθωση. Η μέτρηση μόνο ρεύματος (χωρίς τάση) τρέχει πλέον
    κάθε φορά, σε παράθυρο 1 s (ακριβώς 50 περίοδοι).
2026-11-09 Βαθμονόμηση SCT-013 100A/1V: ICAL 100.7
    Νέο clamp 100A/1V για μέτρηση όλου του σπιτιού στον πίνακα.
    Αμπεροτσιμπίδα 8.59 A, smart meter 8.64 A μετά τη διόρθωση.
    NOISE_I 1.0 A (θόρυβος με το νέο clamp ~0.64 A).
    [smart_meter.ino]
2026-11-09 Αφαίρεση θορύβου από το RMS του ρεύματος
    Ο θόρυβος του καναλιού ρεύματος (6.4 mV στο pin, ~0.64 A) προστίθεται
    τετραγωνικά στο RMS. Τώρα αφαιρείται: Iπραγμ = sqrt(Iμετρ² - Iθορ²).
    NOISE_I 1.0 -> 0.5 A. Έλεγχος με αμπεροτσιμπίδα: 1.18/4.43/7.93 A ->
    1.21/4.45/7.86 A, χωρίς φορτίο 0.000 A.
    [smart_meter.ino]
2026-11-09 Βαθμονόμηση τάσης και φάσης: VCAL 362.2, INVERT_CURRENT 1
    - VCAL 341 -> 362.2 (πολύμετρο 235 V, σειριακή 221.26 V)
    - INVERT_CURRENT 1: το SCT ήταν ανάποδα (P < 0)
    - PHASE_SHIFT 12 επιβεβαιώθηκε με αερόθερμο: PF 1.00, P = V*I
    - ADC_DUMMY_READ (κλειστό): δοκιμή crosstalk του ADC, δεν άλλαξε το Irms
